wearable-posture-team/wearable_posture_correction_device/README.md

# wearable_posture_correction_device
# Keep Moving: Posture Monitoring System

## Key Features
- Dual-mode posture detection (Static and Hunching)
- Real-time alerts via vibration and sound
- Mobile app connectivity
- Customizable alert settings

## Hardware Components
- ESP32 WROOM-32 Microcontroller
- 2x MPU6050 Inertial Measurement Units
- Vibration Motor
- Buzzer
- LiPo Battery

## Key Technologies
- Arduino IDE
- ESP32 Programming
- Bluetooth Connectivity
- MIT App Inventor

## Methodology
The system uses two MPU6050 sensors to:
1. Detect prolonged static postures
2. Identify hunching positions
3. Provide real-time user feedback
